jacobelzey/duck-box/firmware/docs/screens_all_messages.png

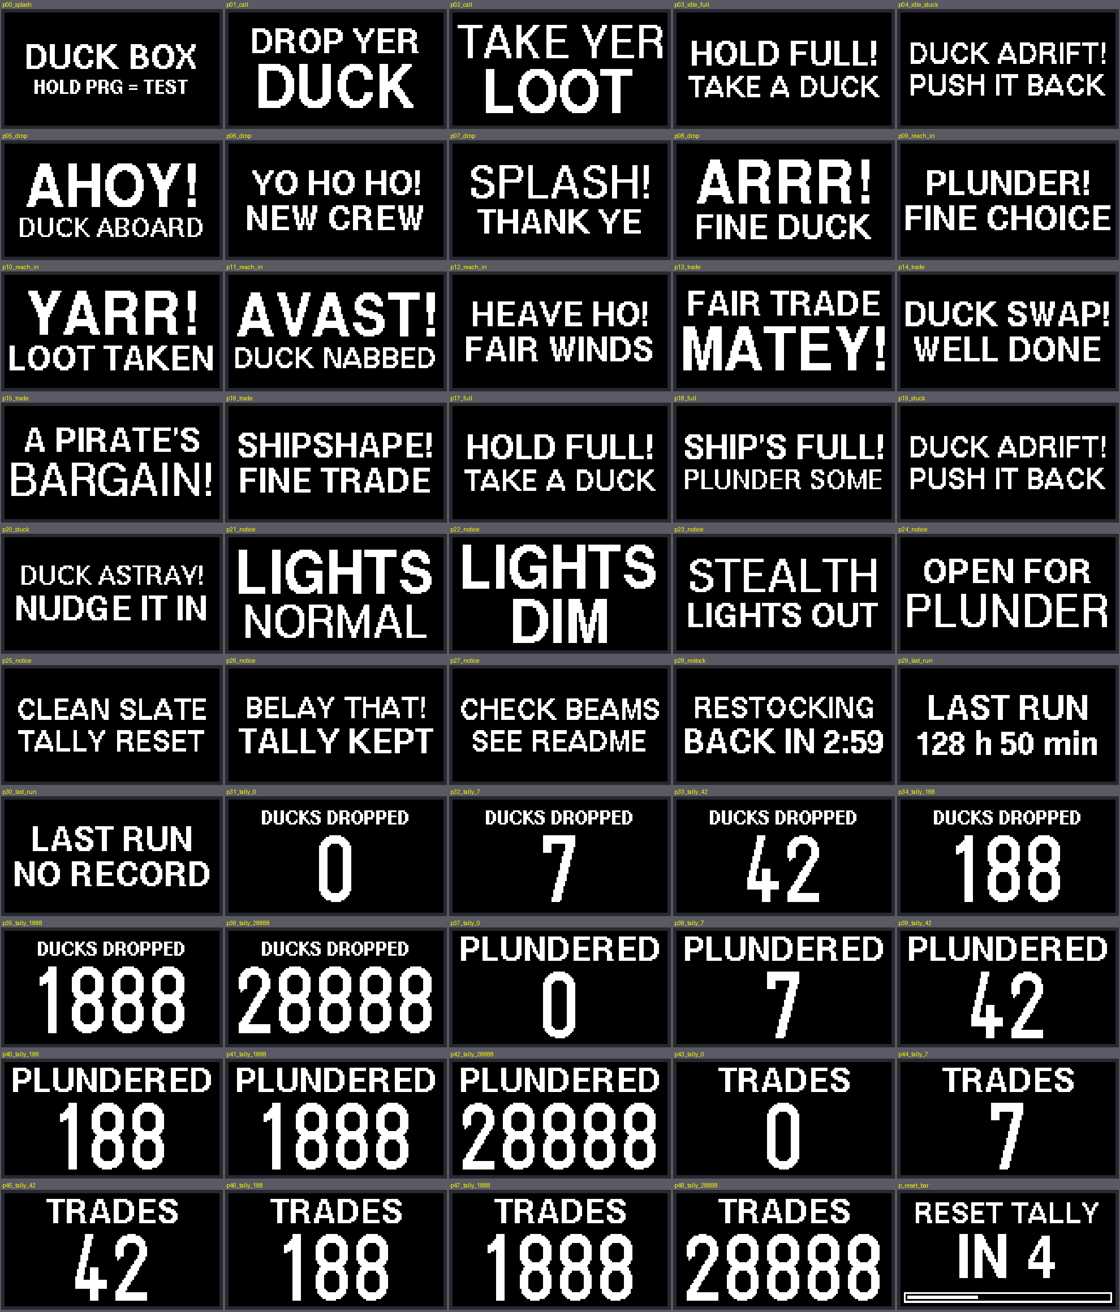
firmware/docs/screens_all_messages.png
