jacobelzey/duck-box/prints/07_screen_cartridge.stl

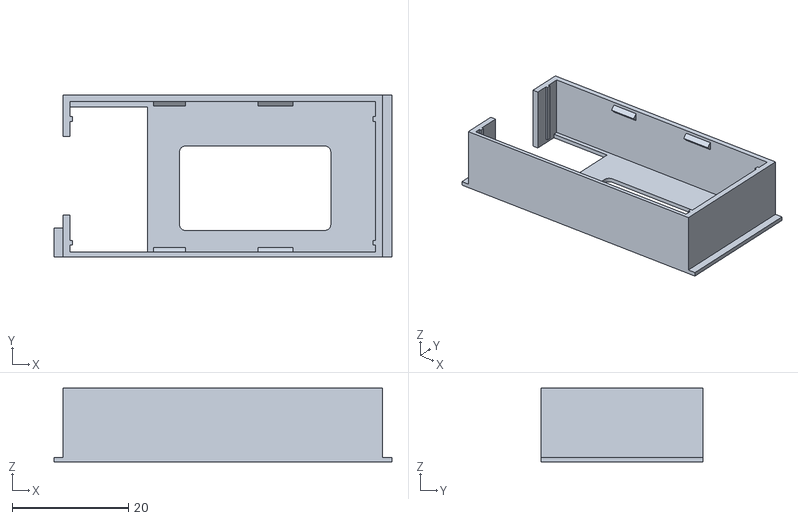
[picture p15: CAD file, 2026-10-14]
prints/07_screen_cartridge.stl
58.1 x 27.8 x 12.7
