jacobelzey/duck-box/prints/11_magnet_test_coupon.stl

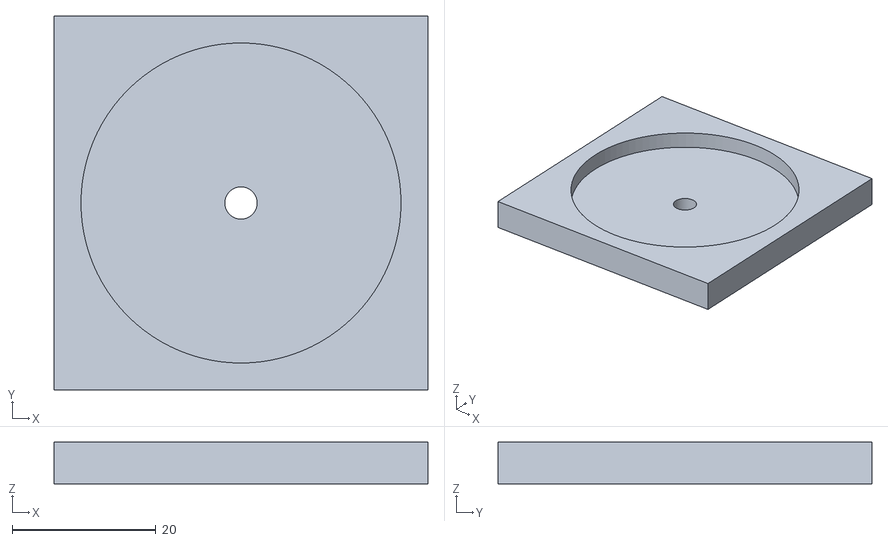
[picture p16: CAD file, 2026-10-14]
prints/11_magnet_test_coupon.stl
52.0 x 52.0 x 5.83
