jacobelzey/duck-box/prints/10_shelf_sensor_block_x2.stl

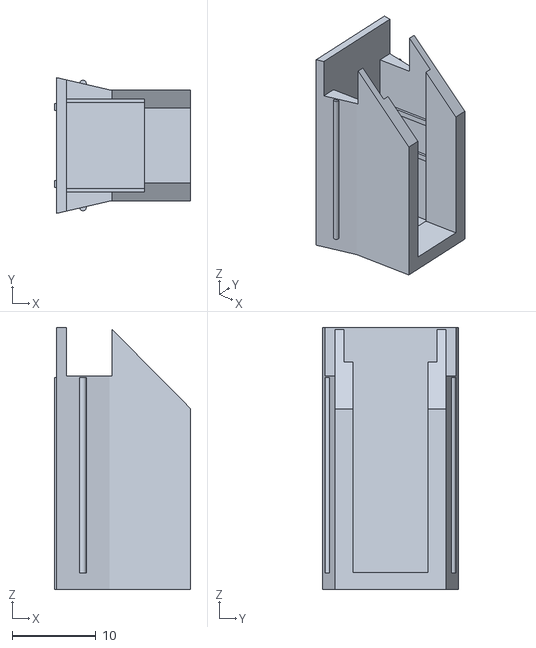
[picture p17: CAD file, 2026-10-14]
prints/10_shelf_sensor_block_x2.stl
16.3 x 16.2 x 31.3
