jacobelzey/duck-box/prints/06_tray_combined_white.stl

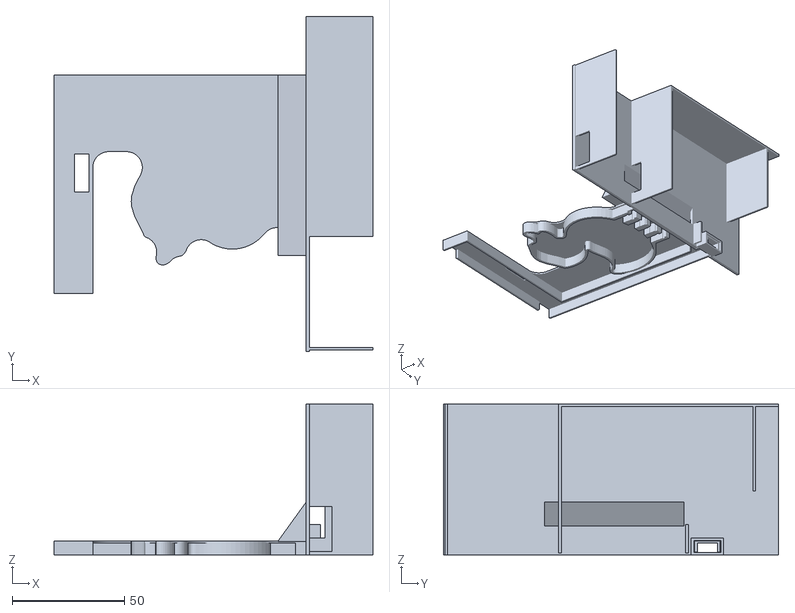
[picture p18: CAD file, 2026-10-14]
prints/06_tray_combined_white.stl
141.8 x 149.0 x 67.1
