jacobelzey/duck-box/prints/09_tray_stop.stl

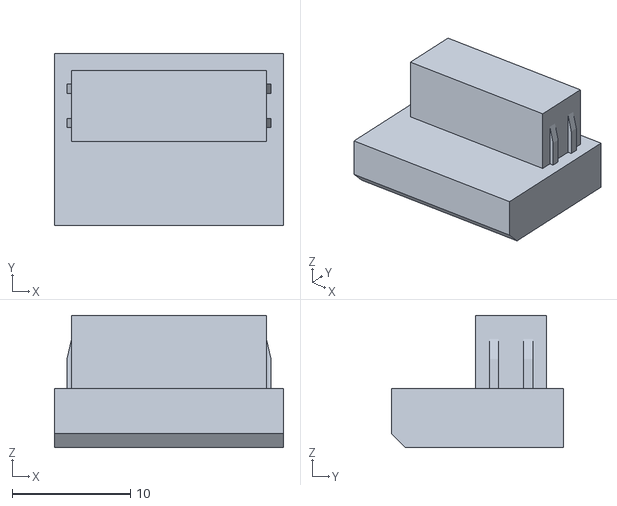
[picture p19: CAD file, 2026-10-14]
prints/09_tray_stop.stl
19.4 x 14.6 x 11.2
