jacobelzey/duck-box/prints/12_screw_spacer_1mm_x6.stl

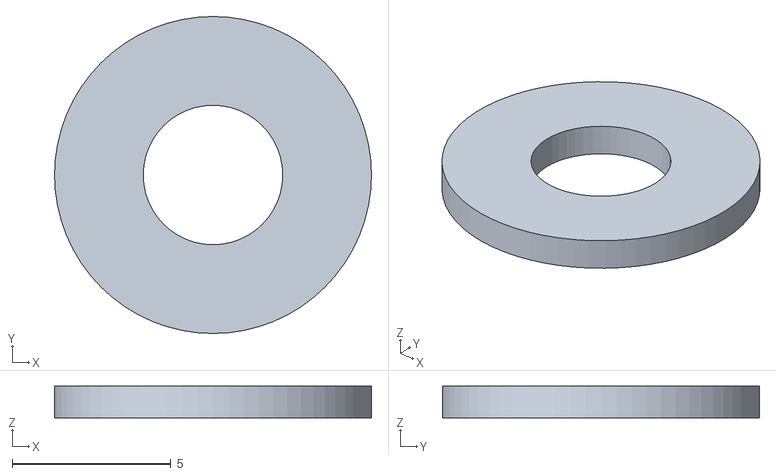
[picture p21: CAD file, 2026-10-14]
prints/12_screw_spacer_1mm_x6.stl
10.0 x 10.0 x 1.00
