jacobelzey/duck-box/docs/breadboard_test_wiring.png

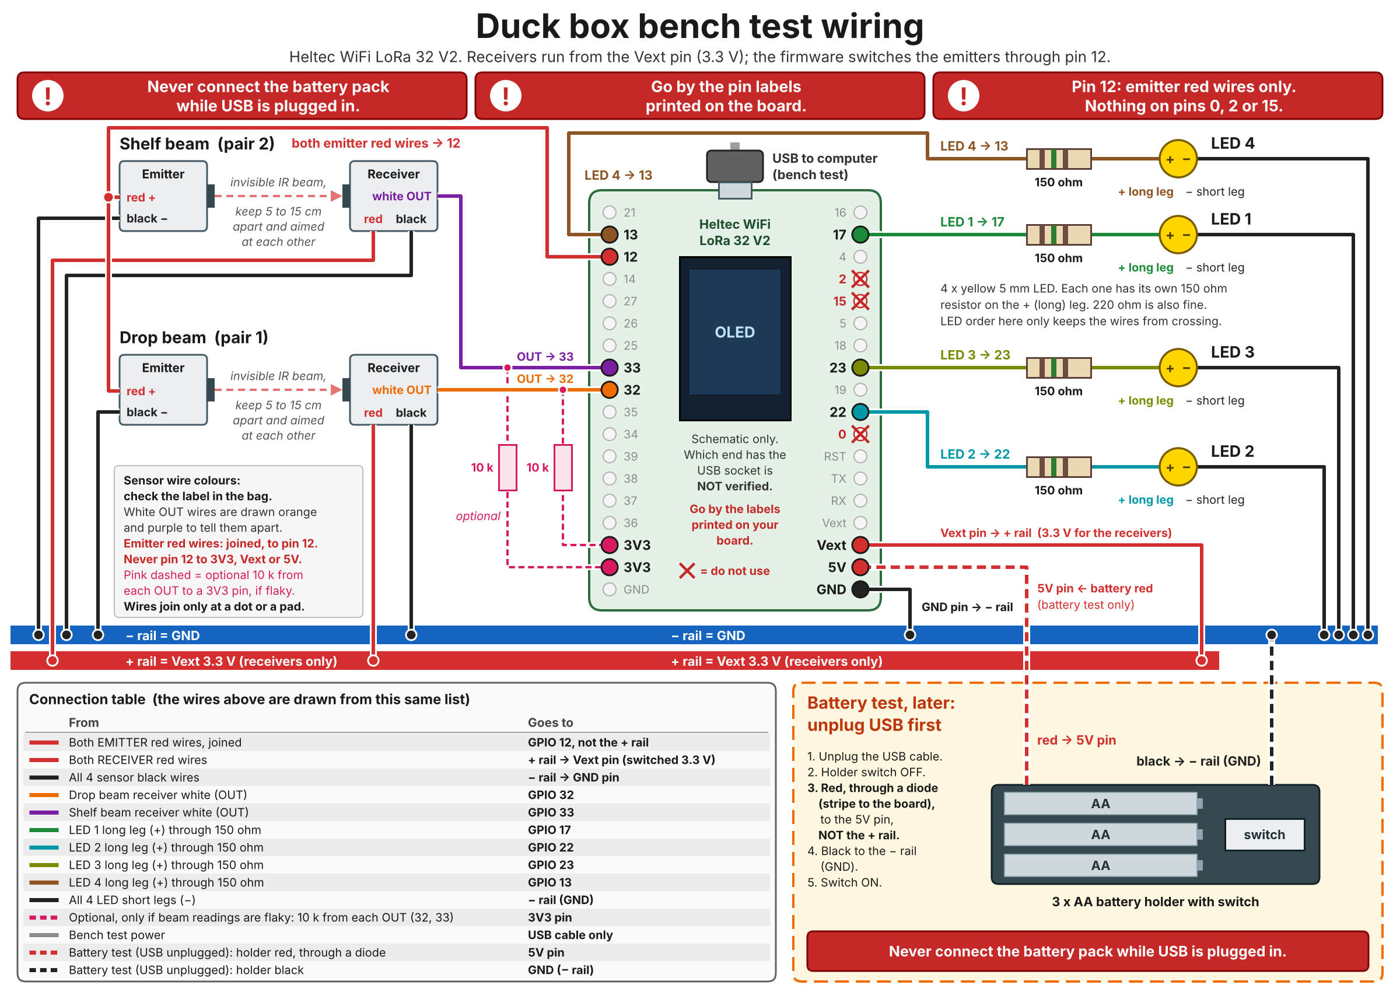
docs/breadboard_test_wiring.png
