jacobelzey/duck-box/docs/wiring/01_leds_into_hood.png

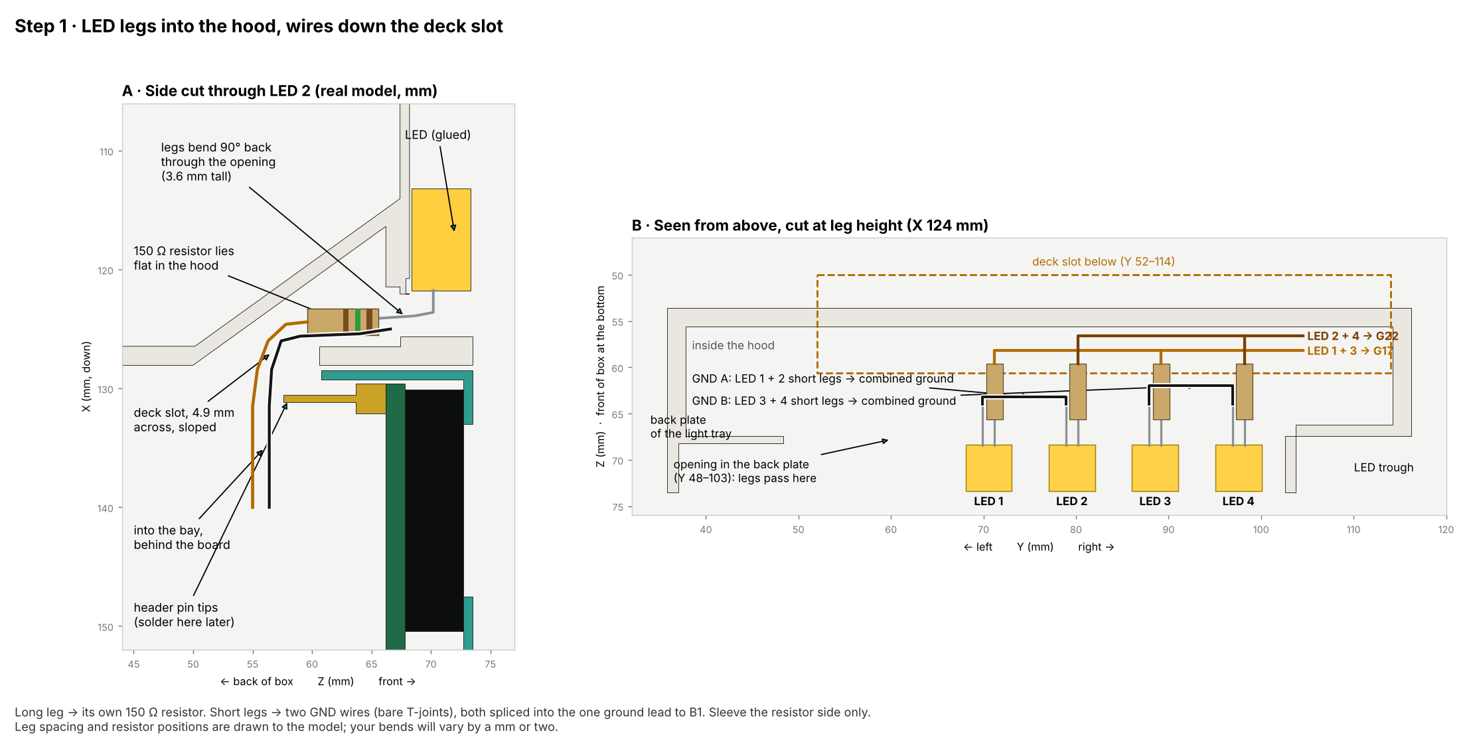
docs/wiring/01_leds_into_hood.png
