jacobelzey/duck-box/docs/wiring/02_cable_routes.png

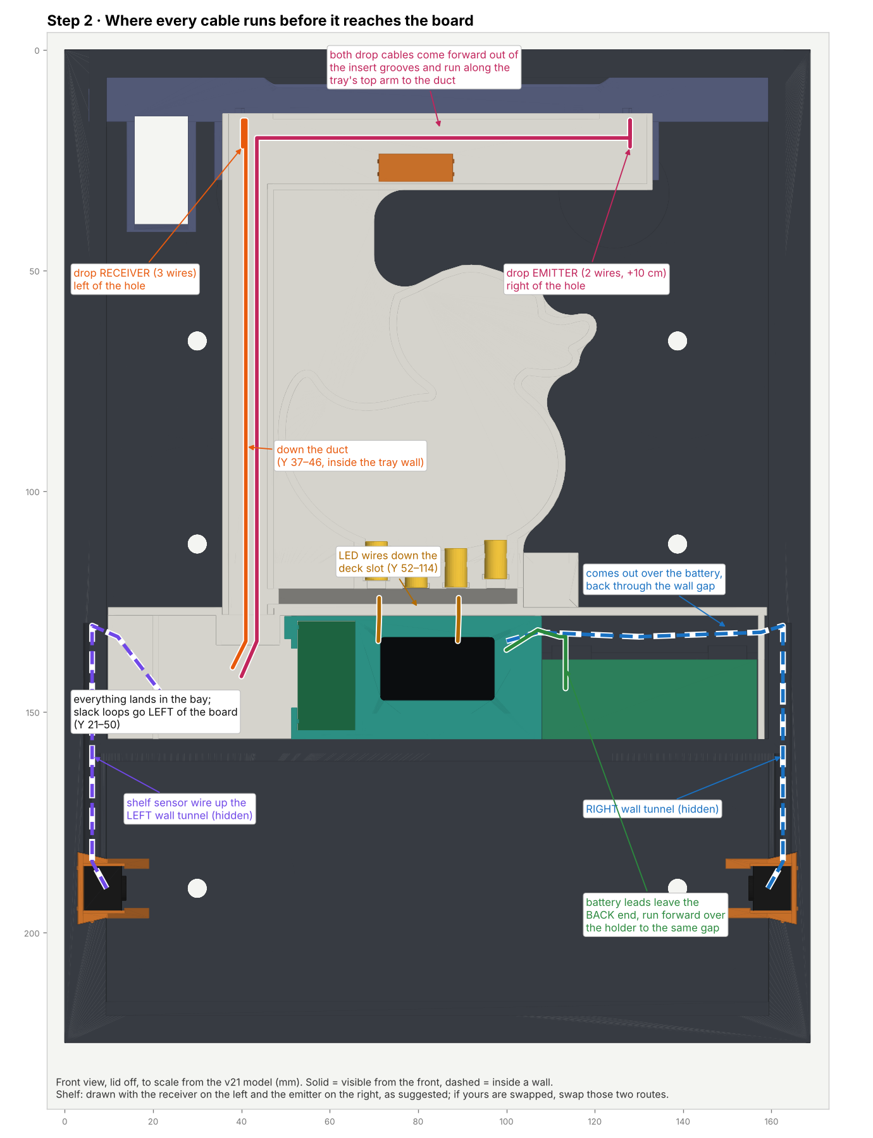
docs/wiring/02_cable_routes.png
