jacobelzey/duck-box/docs/wiring/03_board_pins.png

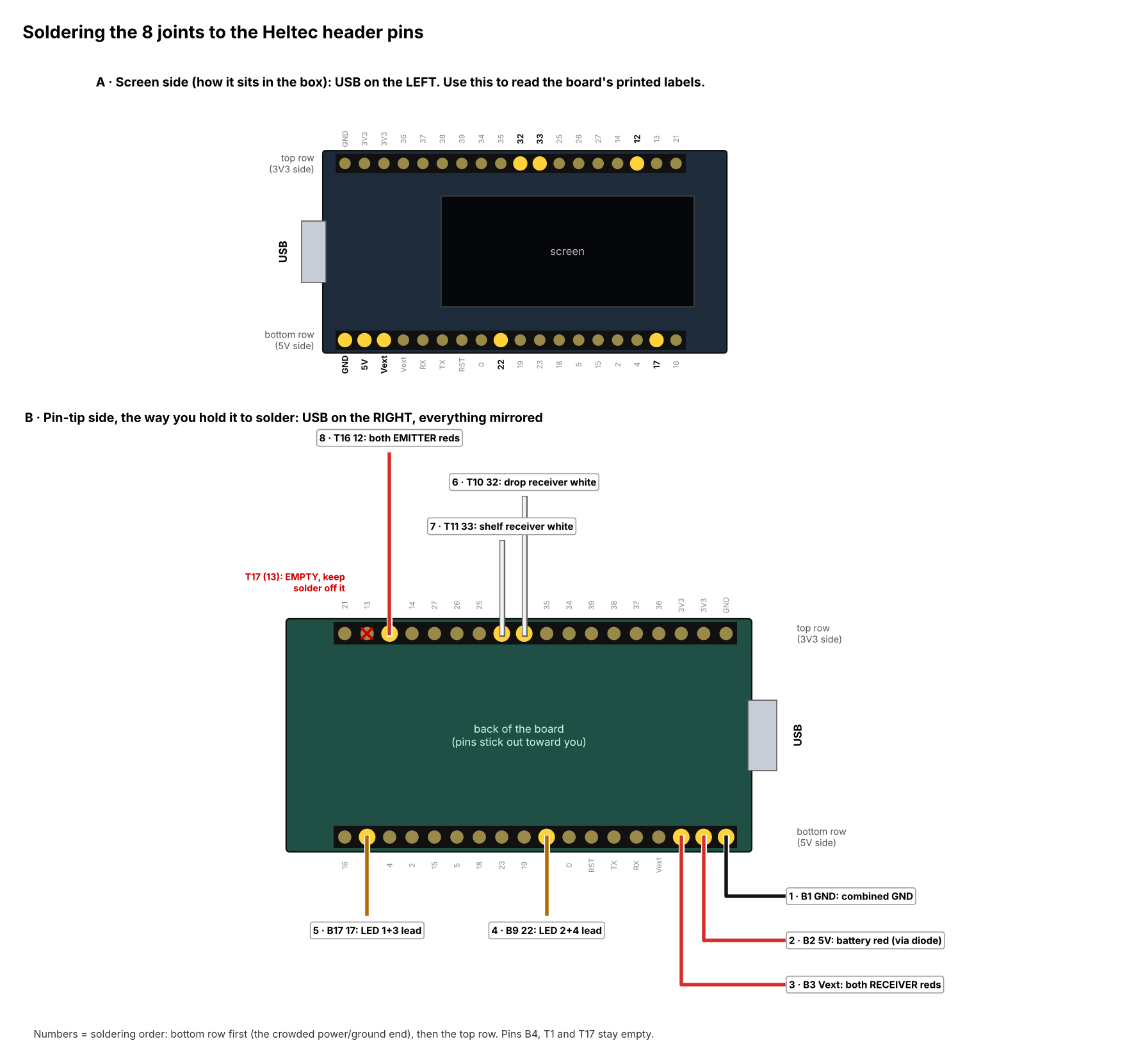
docs/wiring/03_board_pins.png
