jacobelzey/duck-box/docs/wiring/04_harness_meter_checks.png

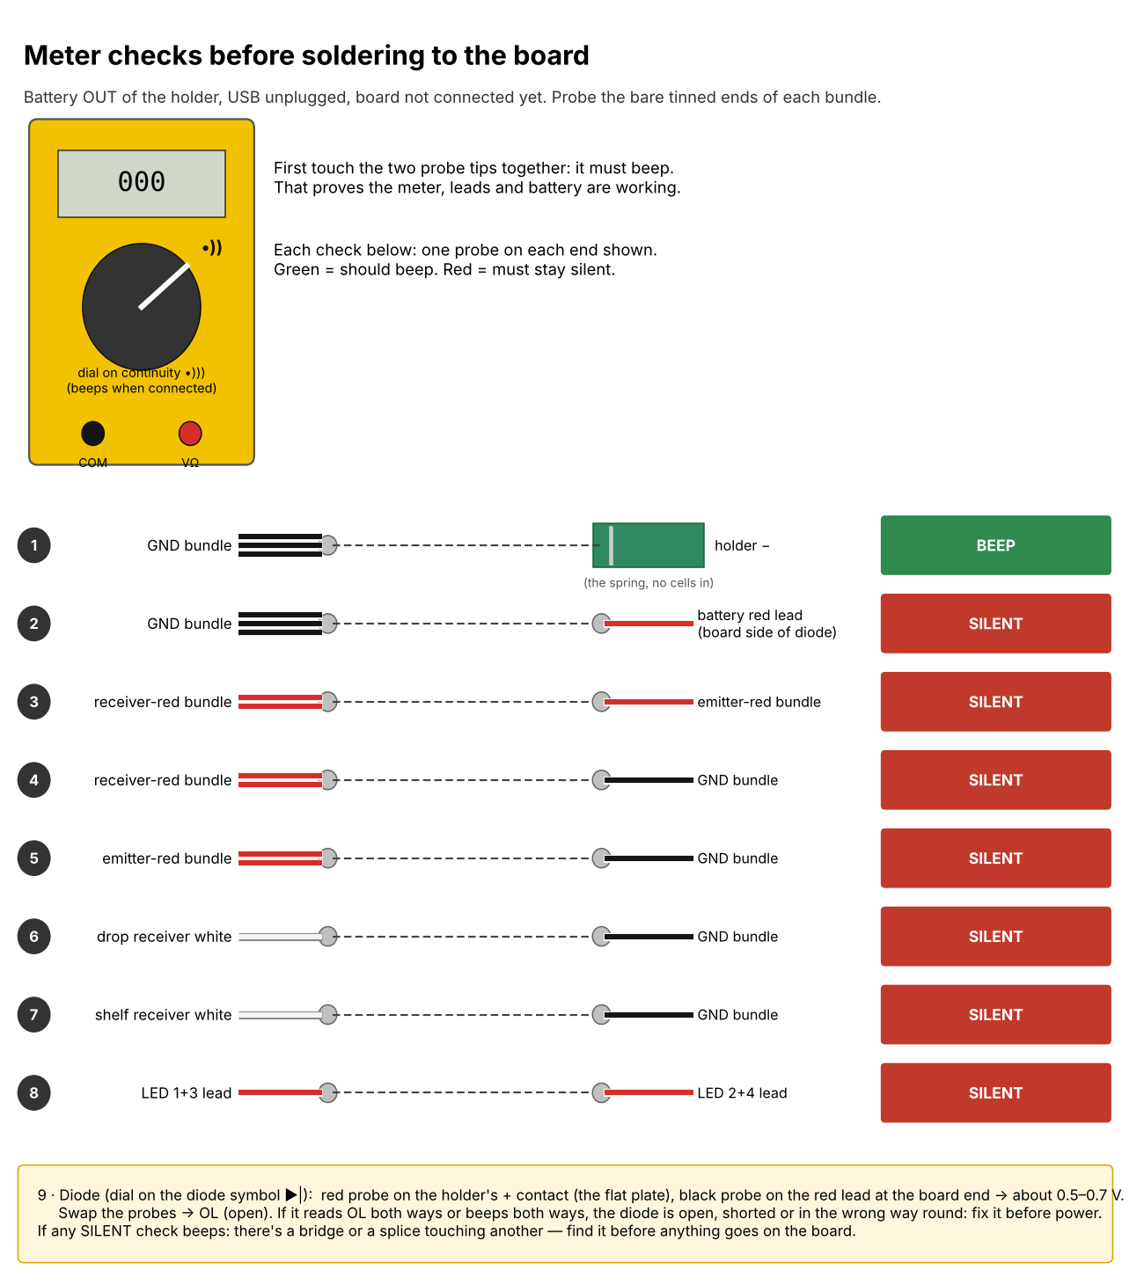
docs/wiring/04_harness_meter_checks.png
