jacobelzey/duck-box/docs/wiring/05_joint_b3_vext.png

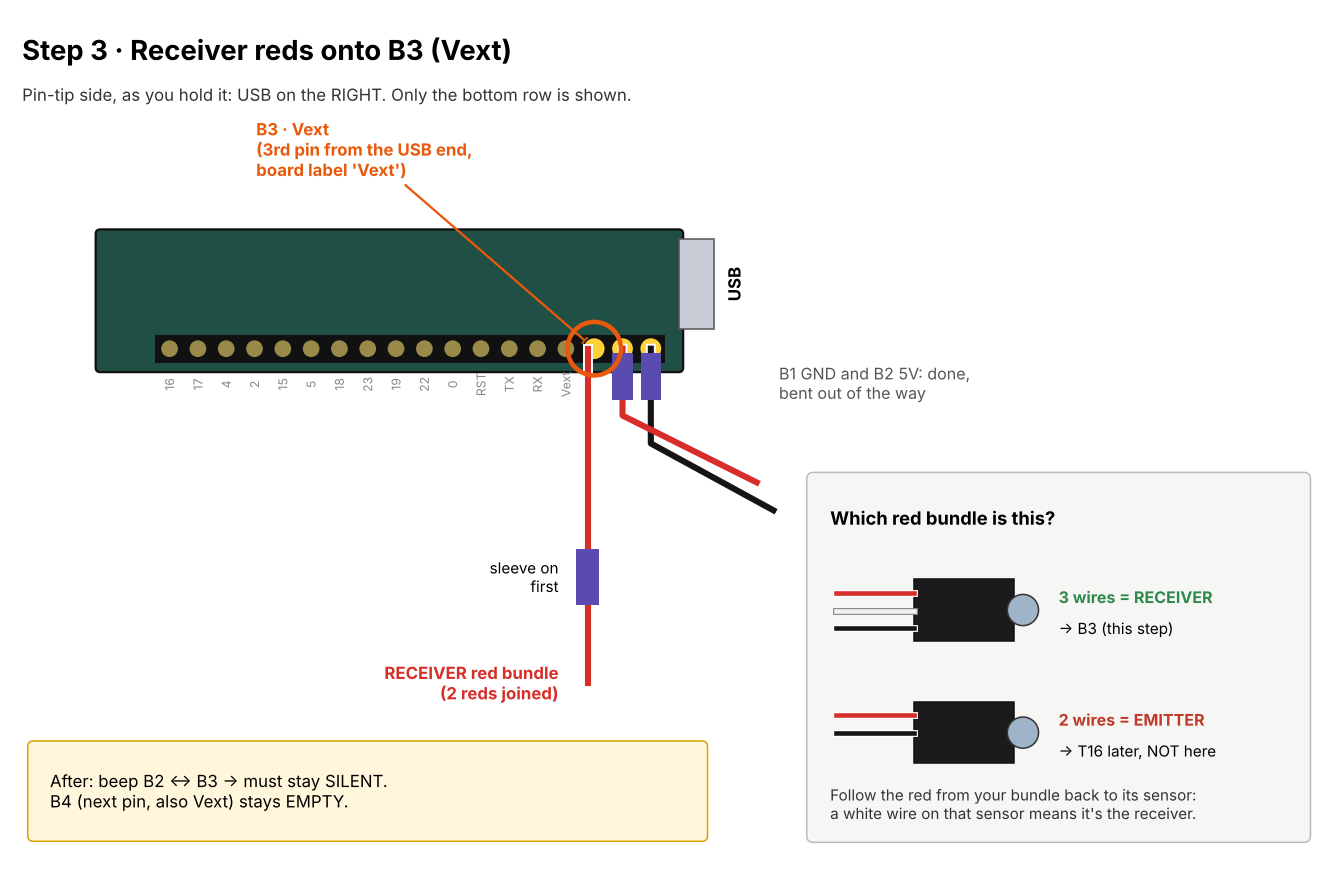
docs/wiring/05_joint_b3_vext.png
