jacobelzey/duck-box/docs/wiring/06_joint_t10_gpio32.png

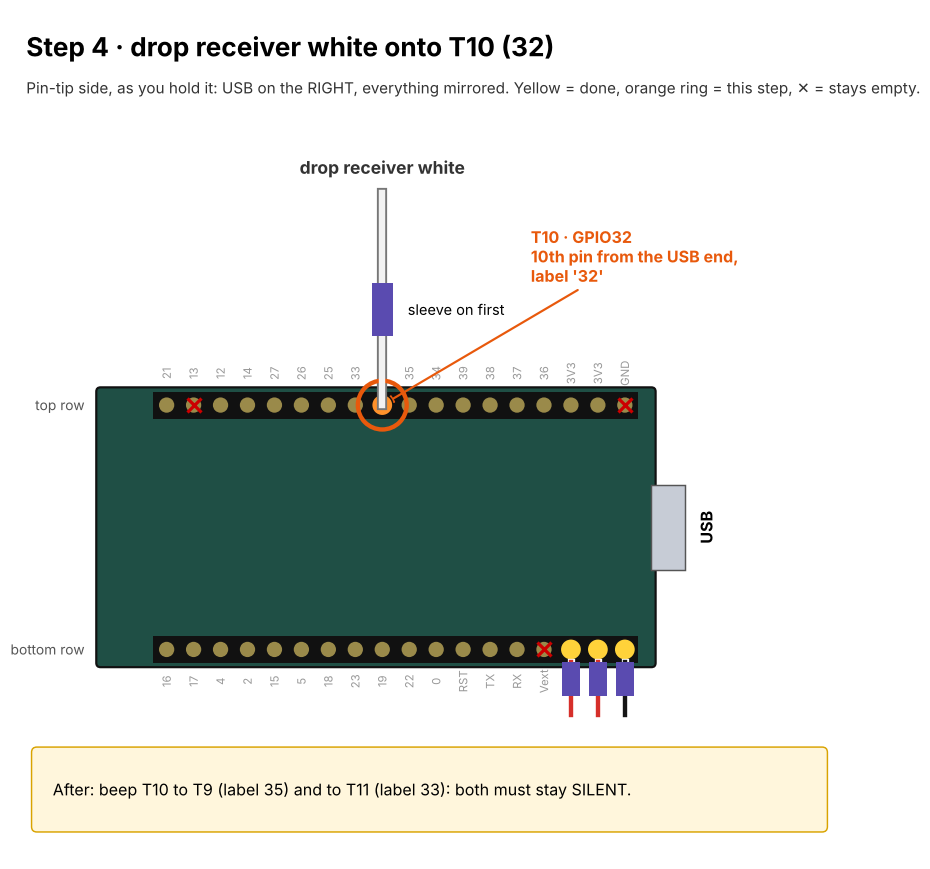
docs/wiring/06_joint_t10_gpio32.png
