jacobelzey/duck-box/docs/wiring/07_joint_t11_gpio33.png

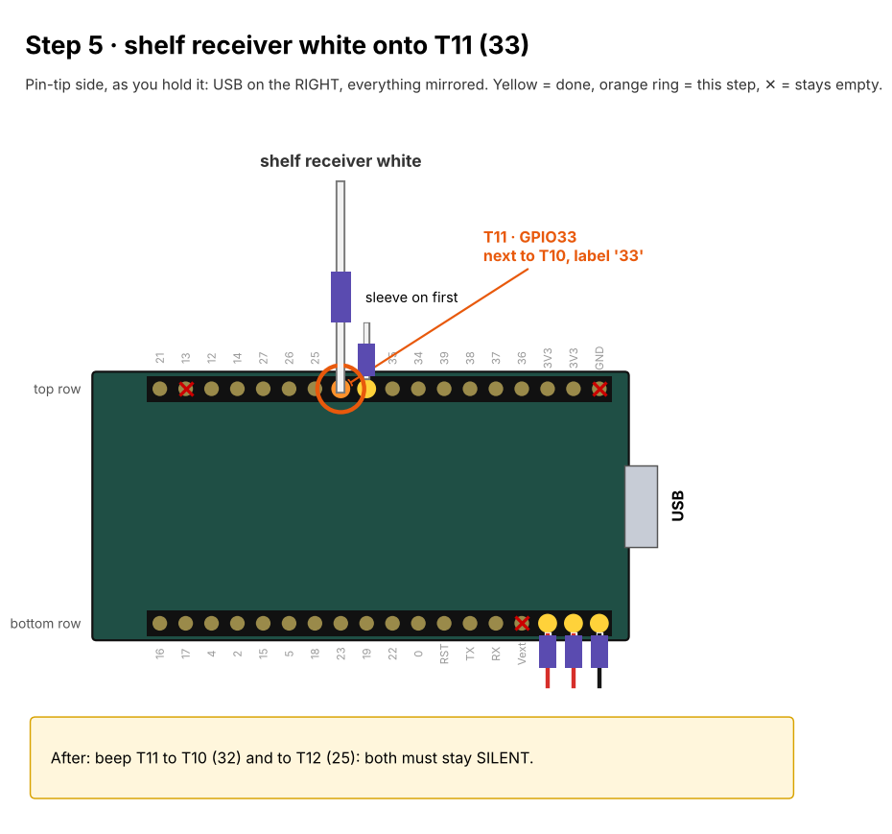
docs/wiring/07_joint_t11_gpio33.png
