jacobelzey/duck-box/docs/wiring/08_joint_t16_gpio12.png

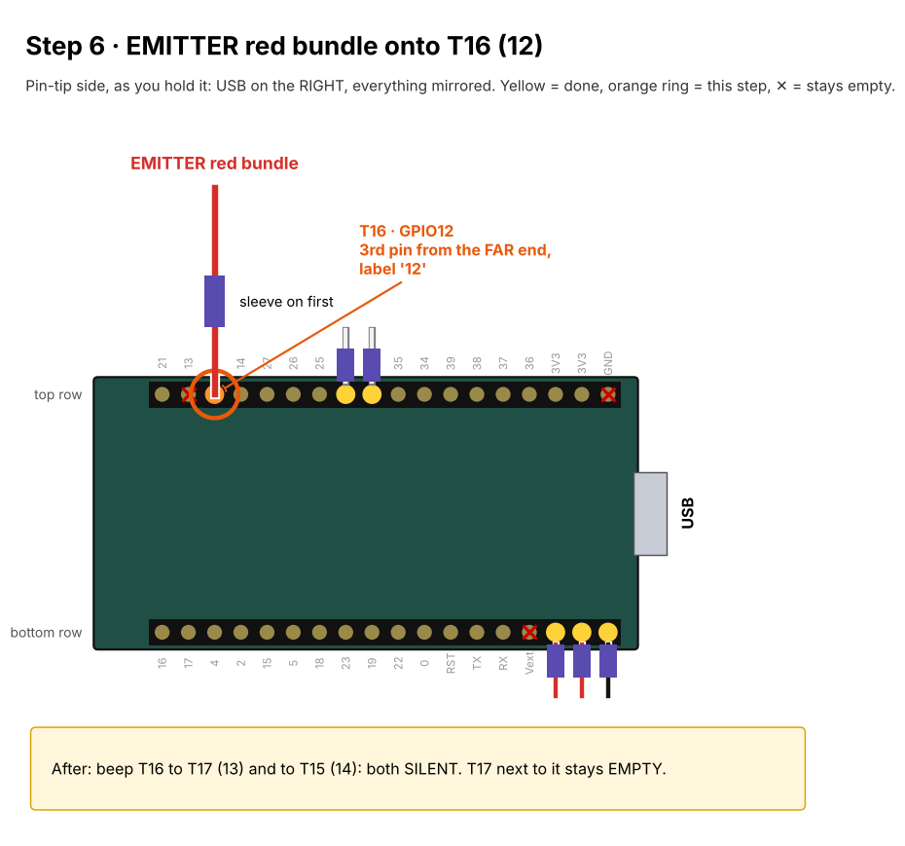
docs/wiring/08_joint_t16_gpio12.png
