jacobelzey/duck-box/docs/wiring/09_joint_b9_gpio22.png

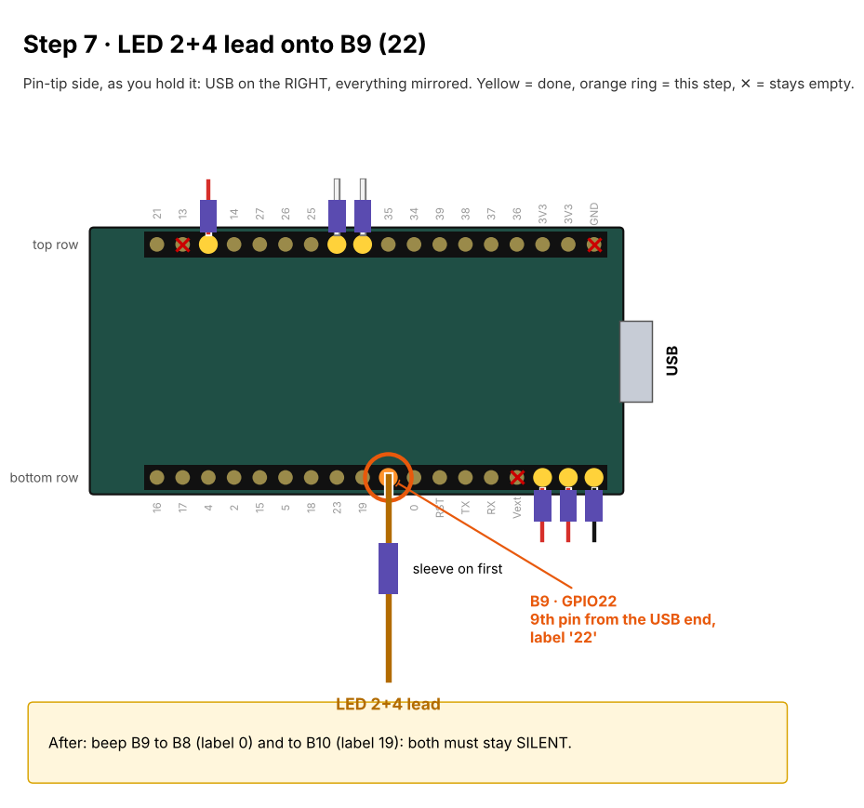
docs/wiring/09_joint_b9_gpio22.png
