jacobelzey/duck-box/docs/wiring/10_joint_b17_gpio17.png

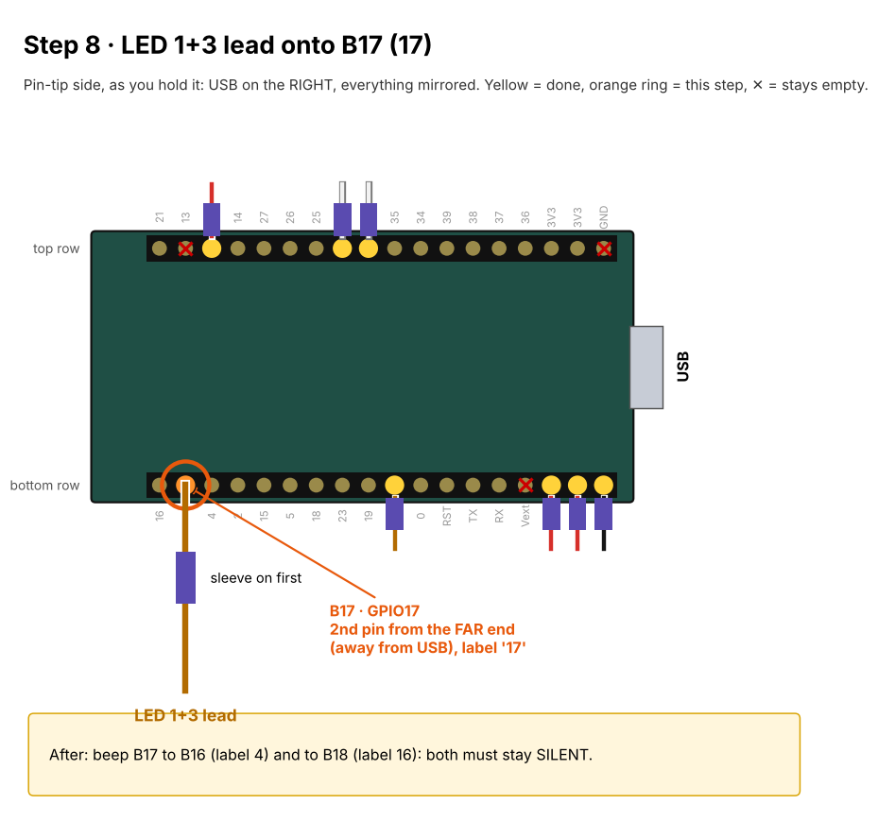
docs/wiring/10_joint_b17_gpio17.png
