jacobelzey/duck-box/docs/wiring/11_bridge_checks.png

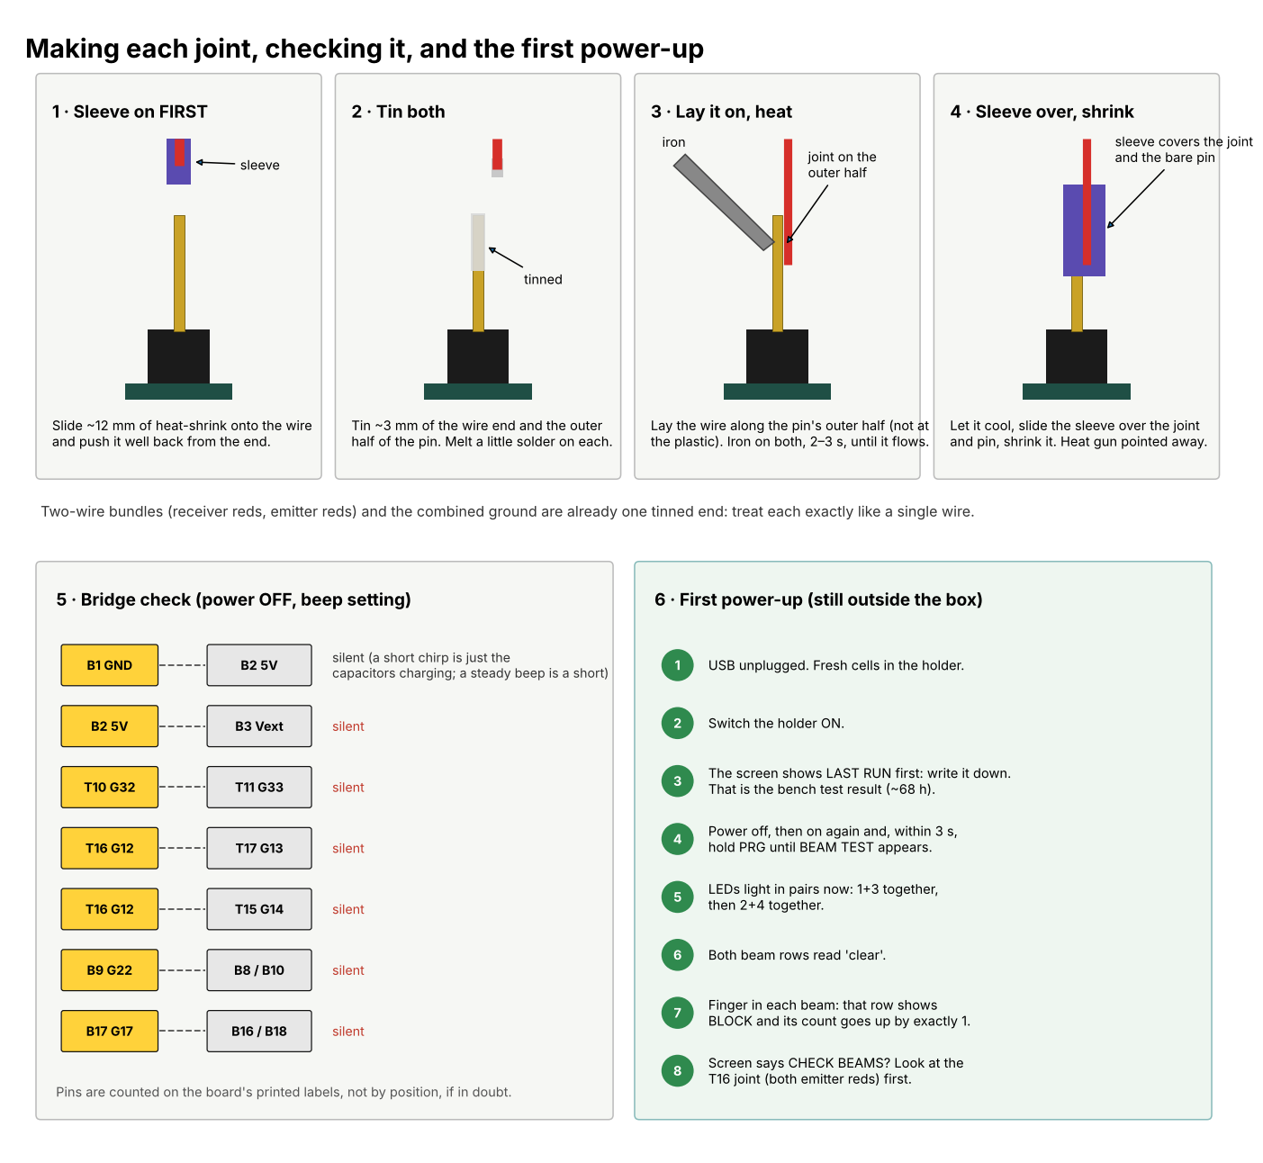
docs/wiring/11_bridge_checks.png
