jacobelzey/duck-box/docs/wiring/12_close_up.png

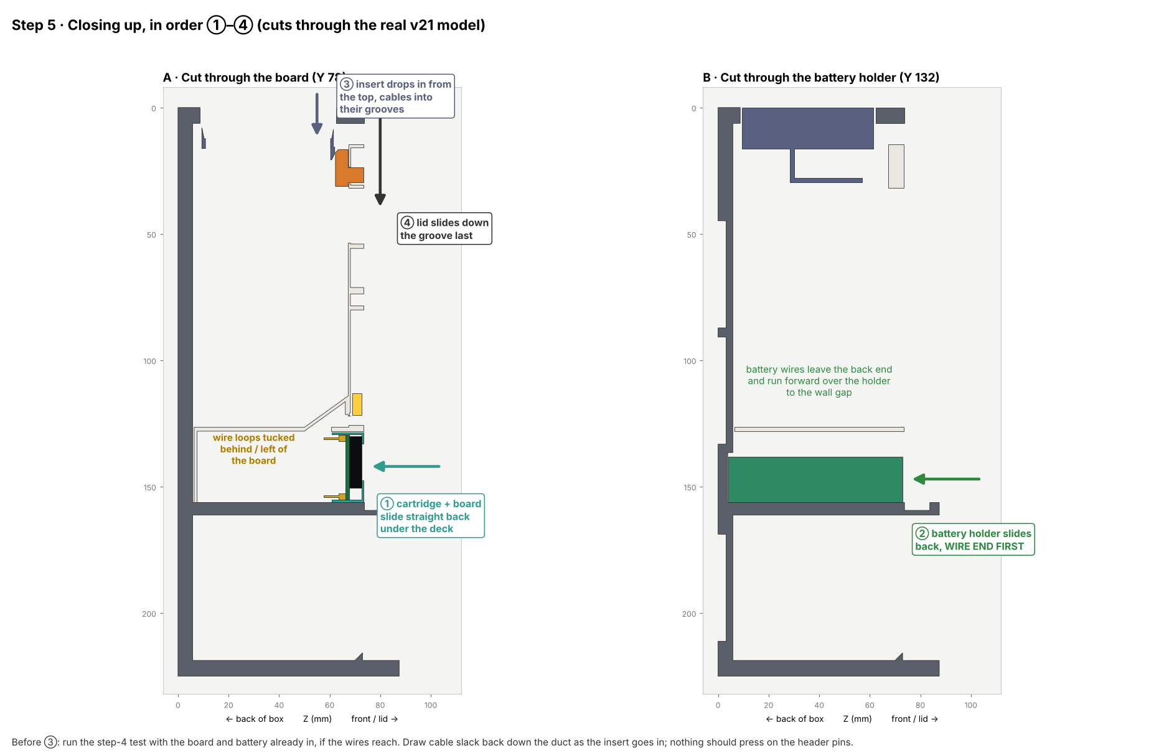
docs/wiring/12_close_up.png
