jacobelzey/duck-box/docs/wiring/battery_cell_test.png

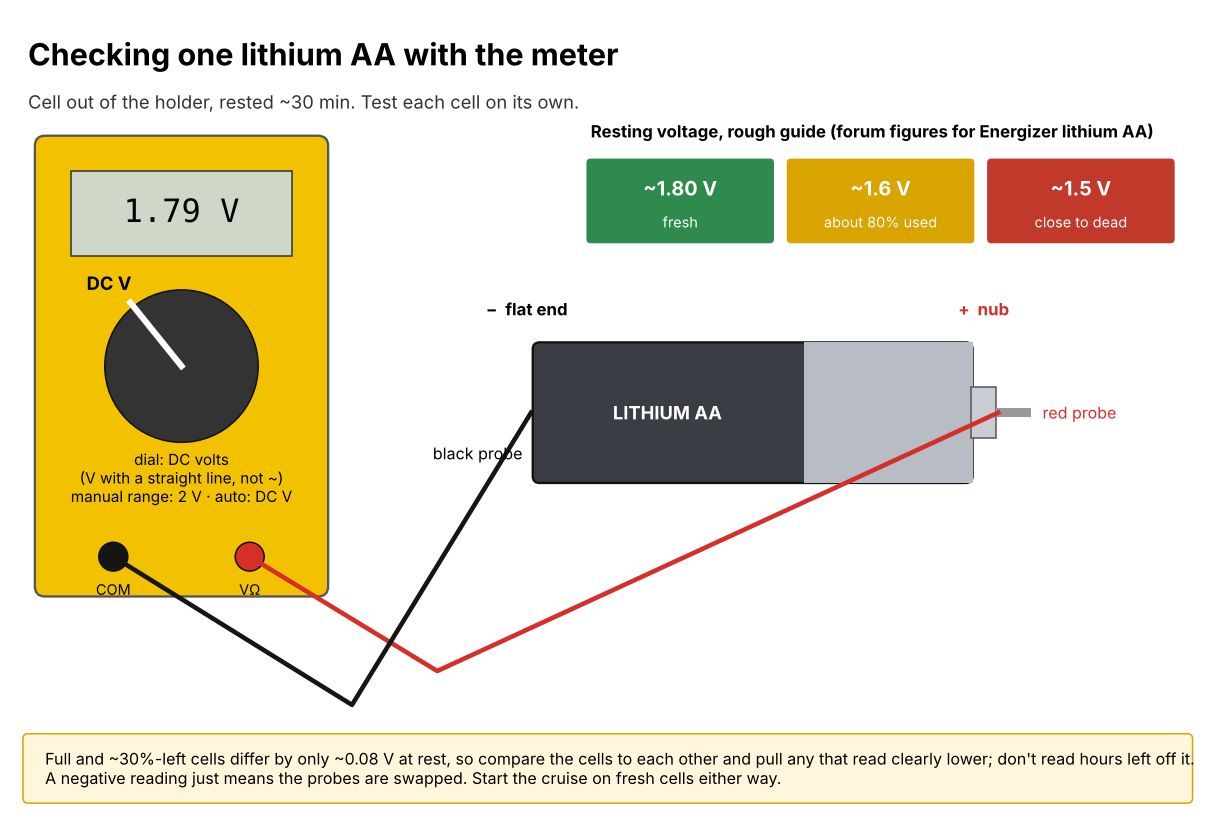
docs/wiring/battery_cell_test.png
