jacobelzey/duck-box/(commit log)

2026-10-14 Duck box: firmware, print files, CAD build and wiring docs
    Claude-Session: https://claude.ai/code/session_01LwUmGTPq2w3jrzQFr4BJQ7
2026-10-14 Add box renders and step-by-step assembly pictures
    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
2026-10-14 License: switch to CC BY-NC-SA 4.0 (non-commercial)
    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
2026-10-15 README: measured battery life, about 88 hours per set
    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
